raymirabel/LoRaTH/Manual Sensor LoRaTH - v1_00 - SPA.pdf

LoRaTH

# LoRaTH

# Sensor temperatura, humedad, CO2 y presión atmosférica, tecnología LoRa

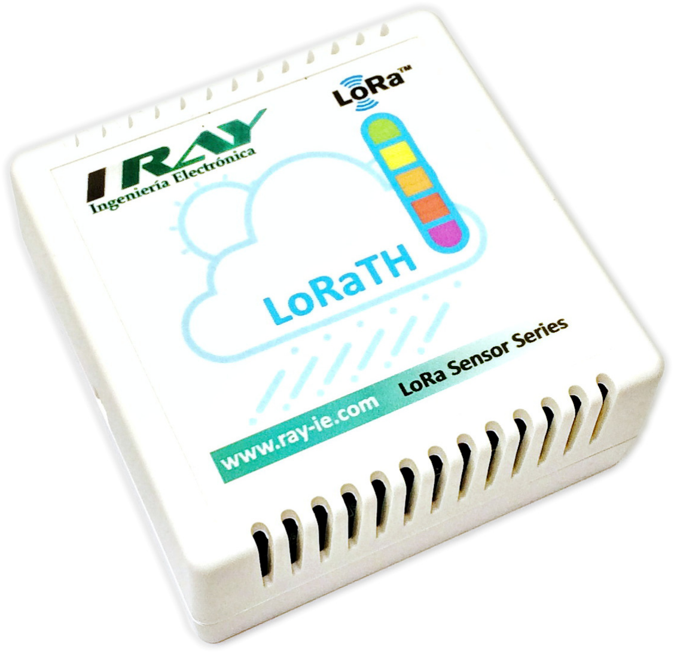
[picture p1: figure]

Modelos disponibles:

- | LoRaTH-TH: | TEMPERATURA Y HUMEDAD (*)
- | LoRaTH-T: | SOLO TEMPERATURA
- | LoRaTH-xxC: | OPCION CO2
- | LoRaTH-xxP | OPCIÓN PRESIÓN ATMOSFÉRICA

Documentación, esquemas, librerías, ejemplos, etc.:

- https://github.com/raymirabel/LoRaTH

LoRaTH

ÍNDICE DE CONTENIDO

LoRaTH

1. Descripción general.

El sensor ambiental LoRaTH es un dispositivo con tecnología LoRa que permite monitorizar parámetros como temperatura, humedad, CO2, presión atmosférica y luz ambiente en entornos interiores a través de las redes IoT (Internet de las Cosas).

LoRaTH incorpora un microcontrolador ATMega328P a 16Mhz y el diseño de la electrónica está basado en arquitectura Arduinotm UNO lo cual nos permite fácilmente modificar el firmware en cualquiera de los entornos de programación compatibles con esta plataforma.

Pueden combinarse, bajo pedido, cualquiera de los distintos sensores disponibles:

- Temperatura y humedad (modelo estándar o base)
- Solo sensor de temperatura
- Opción sensor CO2
- Opción presión atmosférica
- Sensor LDR o luz ambiente integrado en todos los modelos

El sensor se entrega montado en una caja discreta y robusta de plástico ABS para fijar en pared.

Está recomendado para aplicaciones domóticas, monitorización de climatización y calidad del aire en edificios, eficiencia energética, etc.

LoRaTH

2. Características principales.
- Microcontrolador Atmel ATMega328P compartible con Arduino Uno.
- Compatible LoRa/LoRaWAN 868Mhz (RFM95).
- 4 interruptores dipswitch propósito general o dirección de nodo.
- Alimentación pilas 2xAA.
- Regulador conmutado de alta eficiencia y bajo consumo.
- | Medidas | disponibles: | temperatura, | humedad, | CO2, | presión
atmosférica y luz ambiente.
- Tamaño compacto.
- Bajo consumo en modo sleep <20uA.

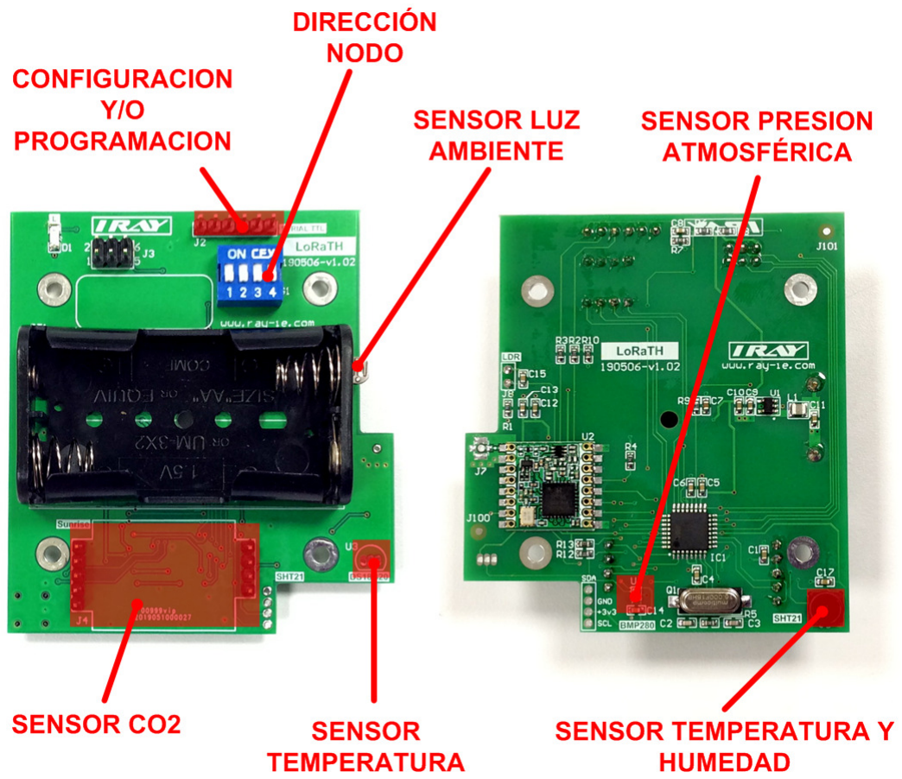
[picture p2: figure]

LoRaTH

3. Microcontrolador.

LoRaTH se entrega con un firmware ejemplo estándar de funcionamiento. Dicho firmware transmite paquetes LoRa cada cierto tiempo con una estructura de datos donde se encuentran los parámetros de las medidas de temperatura, humedad, luz, presión, nivel de batería, etc. Para más información, consulte el apartado 6 sobre la línea de comandos.

Hay disponible una librería y ejemplos para facilitar la programación si desea modificar o mejorar el firmware actual. Puede encontrar el repositorio de librerías, documentación, manuales, etc, en este enlace:

https://github.com/raymirabel/LoRaTH.git

El dispositivo está basado en Arduino y por consiguiente podremos utilizar cualquiera de los entornos de desarrollo Arduino para modificar el firmware.

La equivalencia entre las E/S de LoRaTH y Arduino son las siguientes:

E/S LoRaTH | E/S Arduino
UART RX | 0
UART TX | 1
GPIO0 - IRQ RFM95 | 2
READY SUNRISE | 3
CS RFM95 | 4
GPIO1 - RFM95 | 5
RX SUNRISE | 6
TX SUNRISE | 7
ENABLE SENSOR | 8
LED TEST | 9
ENABLE SUNRISE | 10
DIPSWITCH 1 | A0
DIPSWITCH 2 | A1
DIPSWITCH 3 | A2
DIPSWITCH 4 | A3
DS18B20 DATA | A4
I2C SDA | A4
I2C SCL | A5
VBAT | A6
LDR | A7

LoRaTH

4. Programación.

(*) NOTA IMPORTANTE: Asegúrese que tiene seleccionado, dentro del entorno de desarrollo, como placa el modelo "Arduino UNO".

Disponemos de dos alternativas para programar o modificar el firmware de nuestro sensor LoRaTH:

- Mediante el puerto serie TTL disponible y el bootloader cargado en el microcontrolador. El sensor LoRaTH se entrega con el bootloader de Arduino UNO cargado por lo que solo necesitamos un puerto serie TTL en nuestro ordenador para descargar programas desde el IDE de Arduino.

Existen cables USB comerciales con salida serie TTL. Nosotros recomendamos, el modelo TL-232R-5V de la firma FTDI:

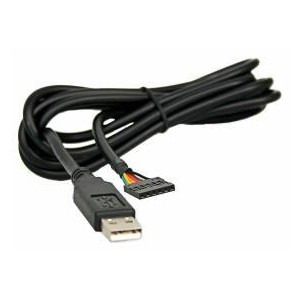
[picture p3: figure]

El pinout del conector J2 es el siguiente:

PIN | SEÑAL | COLOR
1 | GND | NEGRO
2 | CTS | MARRON
3 | NO UTILIZADO | ROJO
4 | TXD (RX del microcontrolador) | NARANJA
5 | RXD (TX del microcontrolador) | AMARILLO
6 | RTS (RESET del microcontrolador) | VERDE

LoRaTH

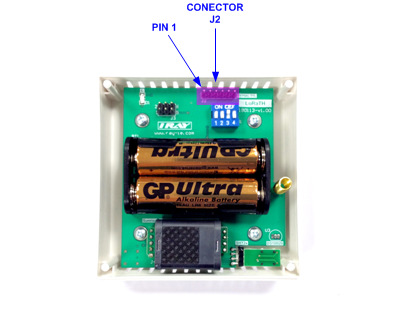
[picture p4: figure]

(*) NOTA IMPORTANTE: Antes de conectar el cable de programación, asegúrese que tiene bien posicionado el conector: PIN1 = GND = CABLE COLOR NEGRO.

- Mediante un programador externo a través del conector ICSP. Esta es la forma nativa de programar los microcontroladores AVR de Atmel. El programador más utilizado para este fin es el AVR MKII:

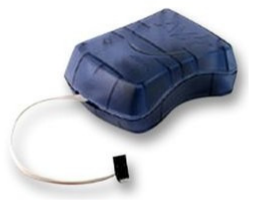
[picture p5: figure]

Para programar el microcontrolador con este programador tenemos que acceder a la placa quitando la tapa superior del sensor:

LoRaTH

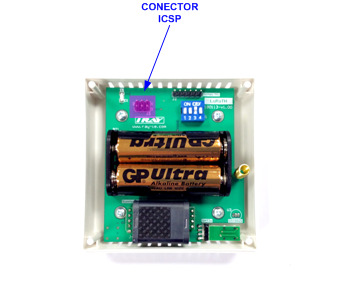
[picture p6: figure]

(*) NOTA IMPORTANTE: Antes de conectar el cable de programación, asegúrese que tiene bien posicionado el conector: PIN1 = CABLE MARCADO CON BANDA ROJA.

5. Sustitución de pilas.

La caja del sensor no incorpora tornillos, por lo tanto para sustituir las pilas, tire de la tapa superior tal como muestra la siguiente imagen:

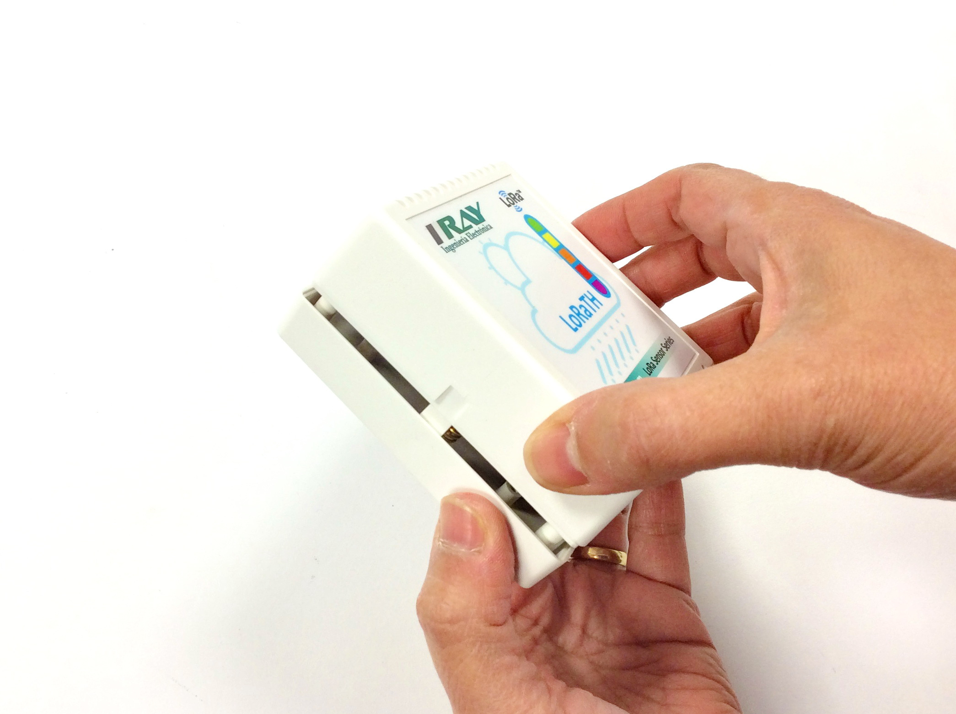
[picture p7: figure]

LoRaTH

6. Línea de comandos.

LoRaTH se entrega con un firmware ejemplo de estándar de funcionamiento llamado "LoRa NODE RAW". Este ejemplo transmite paquetes LoRa cada cierto tiempo con una estructura de datos donde se encuentran los parámetros de las medidas de de temperatura, humedad, luz, presión, nivel de batería, etc.

El firmware "LoRa NODE RAW" incluye una línea de comandos para configurar parámetros y consultar medidas.

Para acceder a la línea de comandos debe conectar un cable compatible SERIE-TTL al conector J8 de LoRaTH y configurar el terminal serie a 9600,N,8,1. Consulte el apartado 5, programación, para más información de cómo conectar un cable serie TTL. Puede usar como terminal serie el que incluye el IDE de Arduino:

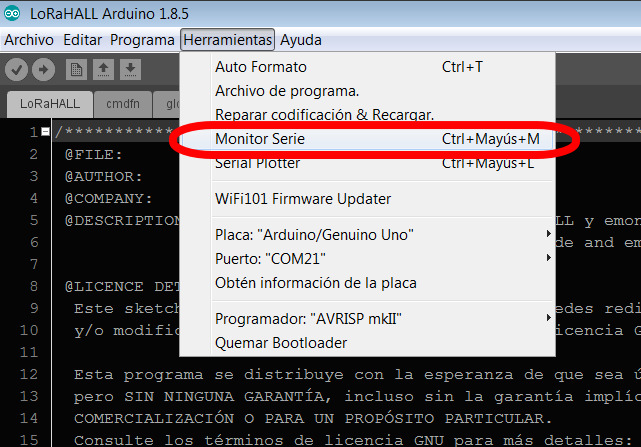
[picture p8: figure]
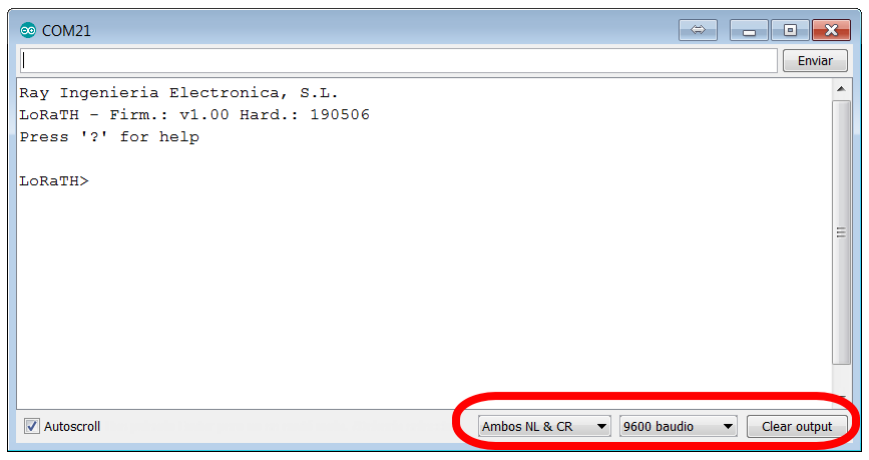
[picture p9: figure]

LoRaTH

Al iniciar el terminal serie aparecerá el siguiente mensaje de bienvenida donde nos indica la versión del firmware y hardware:

Ray Ingenieria Electronica, S.L.

LoRaX1 - Firm.: v1.00 Hard.: 190506

Press '?' for help

Pulse ? para consultar la lista de comandos:

pow | [5...23] | RF power (5:min...23:max)
stime | [1...9999] Send time delay (minutes)
retri | [0...20] | Data send retries
node | [0...250] | Node id
dip | [on|off] | Dipswitch node id function
led | [on|off] | Led test mode
pan | [0...250] | PAN id
read | Read sensors
send | Read and send sensors data to server
all | Read all parameters
? | Command list help

A continuación detallamos cada comando:
- pow: establece la potencia de transmisión LoRa.
- stime: establece el periodo de envío de datos en minutos.
- retri: reintentos de transmisión cuando los datos no llegan al servidor LoRa.
- node: identifica al nodo. Puede haber hasta 250 nodos por cada PAN.
- dip: establece si la dirección del nodo es tomada mediante el dipswitch (dirección de 0 a 15) o mediante el comando "node".
- led: activa o desactiva el LED de test cada vez que el nodo despierta. Este indicador, cuando está activado, nos muestra cuando el nodo está activo leyendo los sensores y transmitiendo los datos. Podemos reducir el consumo desactivando este indicador.

LoRaTH

- pan: identificador PAN o red de área personal. Solo los nodos y servidor con el mismo identificador PAN comunicarán entre sí. Este identificador es útil para separar redes dentro de un mismo área.
- read: lee y muestra de forma inmediata todos los valores de los sensores.
- send: lee y envía de forma inmediata todos los parámetros de energía.
- all: lee y muestra todos los valores de la lista de comandos

Para modificar un valor de un comando escriba el comando y el nuevo valor. Por ejemplo, para modificar la potencia de transmisión al máximo escriba pow 23 (y retorno de carro):

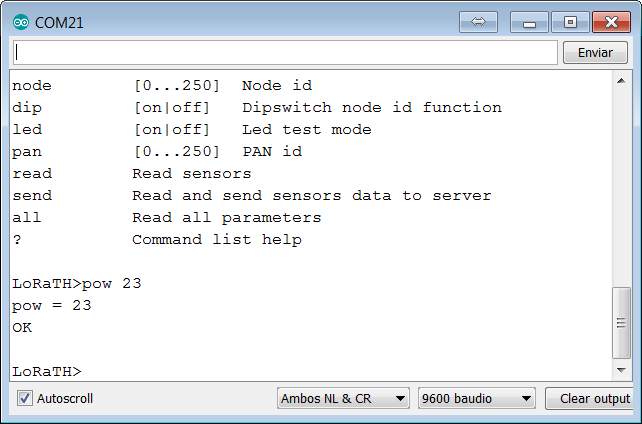
[picture p10: figure]

Para consultar un valor de un comando escriba el comando y pulse retorno de carro.

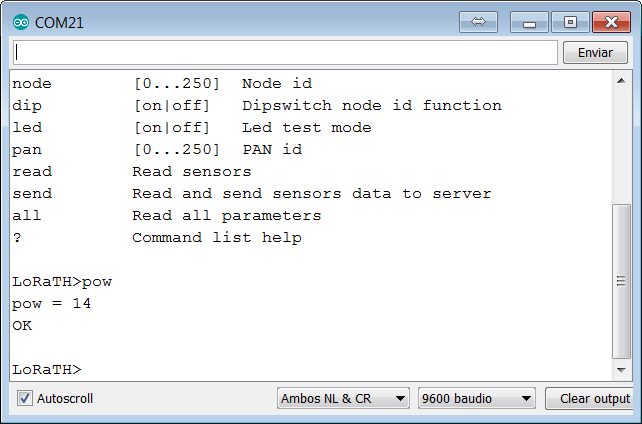
[picture p11: figure]

LoRaTH

7. Especificaciones técnicas generales.
- | Alimentación: | 2xAA (alcalina)
- | Rango de funcionamiento: | 1.5 ~ 3.3 VDC
- | Consumo máximo: | 130mA
- | Consumo sensor off: | 10mA
- | Consumo modo sleep: | 20uA
- | Microcontrolador: | Atmega328P @ 16Mhz
- | Memoria Flash: | 32K
- | Memoria RAM: | 2Kb
- | Transceiver LoRa: | RFM95
- | Temperatura de funcionamiento: | -10 ~ 60 ºC
- | Grado de protección IP: | IP40
- | Ancho: | 84 mm
- | Alto: | 84 mm
- | Fondo: | 36 mm
- | Peso (pilas inc.): | 150 g.

LoRaTH

8. Especificaciones sensor solo temperatura.
- | Modelo: | LoRaTH-T
- | Tipo sensor: | DS18B20+ (DALLAS-MAXIM)
- | Interface: | 1-wire
- | Resolución: | 0.1ºC
- | Rango de medida: | -40 ~ 85ºC
- | Precisión típica: | +/- 0.1ºC
- | Precisión máxima: | +/- 1ºC
9. Especificaciones sensor temperatura y humedad.
- | Modelo: | LoRaTH-TH
- | Tipo sensor: | SHT21 (SENSIRION)
- | Interface: | I2C
- | Resolución temperatura: | 0.1ºC
- | Rango de medida: | -40 ~ 85ºC
- | Precisión típica: | +/- 0.3ºC
- | Precisión máxima: | +/- 1ºC
- | Resolución humedad: | 1%
- | Rango de medida: | 0 ~ 100%RH
- | Precisión típica: | +/- 2%RH
- | Precisión máxima: | +/- 5%RH

LoRaTH

10.Especificaciones sensor CO2.

- | Modelo: | LoRaTH-xxC
- | Tipo sensor: | SUNRISE (SENSE AIR)
- | Tecnología sensor: | Infrarrojos
- | Interface: | SERIAL TTL MODBUS
- | Resolución: | 1ppm
- | Rango de medida: | 400 ~ 10000ppm
- | Precisión típica: | +/- 3% (400 ~ 5000ppm) +/- 10% (400 ~ 10000ppm)
- Rango temperatura operación: 0ºC ~ 50ºC
- | Rango humedad operación: | 0 ~ 85%RH

11.Especificaciones sensor de presión atmosférica.

- | Modelo: | LoRaTH-xxP
- | Tipo sensor: | BMP280 (BOSCH)
- | Interface: | I2C
- | Resolución: | 0.1 hPa
- | Rango de medida: | 300 ~ 1100 hPa
- | Precisión típica: | +/- 1 hPa

LoRaTH

12.Historial de revisiones.

FECHA | VERSION | NOTAS
28/04/2019 | 1.00 | - Documento inicial.
